raisrmdhnar2/PP2/setup.txt

https://data.mendeley.com/datasets/z3g26tphnv/5

wget --content-disposition "https://data.mendeley.com/public-api/zip/z3g26tphnv/download/5"

# Buat environment Conda dan instal dependensi notebook (CPU)
conda create -n arm-ai-fatigue python=3.10 -y
conda activate arm-ai-fatigue
conda install -c conda-forge numpy pandas scipy matplotlib seaborn scikit-learn tensorflow openpyxl onnx jupyterlab ipykernel -y
conda install -c pytorch pytorch cpuonly -y

vela model_int8.tflite --accelerator-config ethos-u55-64 --output-dir ./vela_out

* Build CPU

cmake .. -DUSE_CASE_BUILD=inference_runner \
    -Dinference_runner_MODEL_PATH=$HOME/Arm-Ai-Fatigue/models/final_model_int8.tflite \
    -DTARGET_PLATFORM=mps3 -DTARGET_SUBSYSTEM=sse-300 \
    -DETHOS_U_NPU_ENABLED=OFF \
    -DCPU_PROFILE_ENABLED=ON \
    -DCMAKE_TOOLCHAIN_FILE=scripts/cmake/toolchains/bare-metal-gcc.cmake

make -j4

FVP300 -C mps3_board.visualisation.disable-visualisation=1 \
  -a bin/mlek_inference_runner.axf

*Build NPU

cmake .. -DUSE_CASE_BUILD=inference_runner \
    -Dinference_runner_MODEL_PATH=$HOME/Arm-Ai-Fatigue/models/vela_out/final_model_int8_vela.tflite \
    -DTARGET_PLATFORM=mps3 -DTARGET_SUBSYSTEM=sse-300 \
    -DETHOS_U_NPU_ENABLED=ON \
    -DETHOS_U_NPU_CONFIG_ID=H64 \
    -DCMAKE_TOOLCHAIN_FILE=scripts/cmake/toolchains/bare-metal-gcc.cmake

cmake .. \
  -DUSE_CASE_BUILD=inference_runner \
  -Dinference_runner_MODEL_PATH=/home/nexus_is/Arm-Ai-Fatigue/models/vela_out/final_model_int8_vela.tflite \
  -DTARGET_PLATFORM=mps3 \
  -DTARGET_SUBSYSTEM=sse-300 \
  -DETHOS_U_NPU_ENABLED=ON \
  -DETHOS_U_NPU_CONFIG_ID=H64 \
  -DCMAKE_TOOLCHAIN_FILE=scripts/cmake/toolchains/bare-metal-gcc.cmake

make -j4

FVP300 \
  -C mps3_board.visualisation.disable-visualisation=1 \
  -C ethosu.num_macs=64 \
  -a bin/mlek_inference_runner.axf

# 1. Build (di luar venv, cukup make -j4 jika hanya update cvapp_mb_cls.cpp / golden_data.h)
cd ~/5.Project/Groove-Vision-Ai-v2/tinyml-arm-workflow/third_party/Seeed_Grove_Vision_AI_Module_V2/EPII_CM55M_APP_S
make clean
make -j4 2>&1 | grep -E "Compiling|Linking|error"

# 2. Generate image
cd ../we2_image_gen_local
cp ../EPII_CM55M_APP_S/obj_epii_evb_icv30_bdv10/gnu_epii_evb_WLCSP65/EPII_CM55M_gnu_epii_evb_WLCSP65_s.elf input_case1_secboot/
./we2_local_image_gen project_case1_blp_wlcsp.json

# 3. Flash firmware + model VELA sekaligus (dalam venv)
conda activate tinyml
cd ..
python3 xmodem/xmodem_send.py --port=/dev/ttyACM0 --baudrate=921600 --protocol=xmodem \
  --file=we2_image_gen_local/output_case1_sec_wlcsp/output.img \
  --model="/home/nexus_is/5.Project/Groove-Vision-Ai-v2/PP2/model/vela_out/model_int8_vela.tflite 0xB7B000 0x00000"
# Tekan RESET di board saat diminta

# 4. Baca serial — TFLM firmware baudrate 921600 (BUKAN 115200!)
picocom -b 921600 /dev/ttyACM0

python3 ~/5.Project/Groove-Vision-Ai-v2/PP2/model/upload_infer_grove.py \
  --image ~/5.Project/Groove-Vision-Ai-v2/PP2/data/Sexing-Chicken-2/test/hen/hen_393_jpg.rf.19856f51c6d1ed3054dbba6683129cc8.jpg

python3 ~/5.Project/Groove-Vision-Ai-v2/PP2/model/upload_infer_grove.py \
  --image ~/5.Project/Groove-Vision-Ai-v2/PP2/data/Sexing-Chicken-2/test/cock/cock_109_jpg.rf.24143949c79b5dc8d62dc826fa0e94d4.jpg

python3 ~/5.Project/Groove-Vision-Ai-v2/PP2/model/upload_infer_grove.py --blank

python3 ~/5.Project/Groove-Vision-Ai-v2/PP2/model/upload_infer_grove.py
